GODARC0/hardware-projects/README.md

# Hardware Projects

A collection of my hardware projects — microcontroller builds, embedded systems, circuits, and anything else that isn't purely software.

Not limited to any one platform (Arduino, ESP32, etc.) — this repo just holds all of it.

---

## Structure

Each project lives in its own folder, named after the project. Inside you'll typically find the source code, and any relevant schematics/notes for that build.

```
hardware-projects/
├── Self balancer robot/
├── evm/
├── password based lock/
└── ...more added over time
```

New projects get added as new top-level folders.

---

## License

MIT
