GODARC0/hardware-projects/Self balancer robot/images and diagram/Block_diagram.png

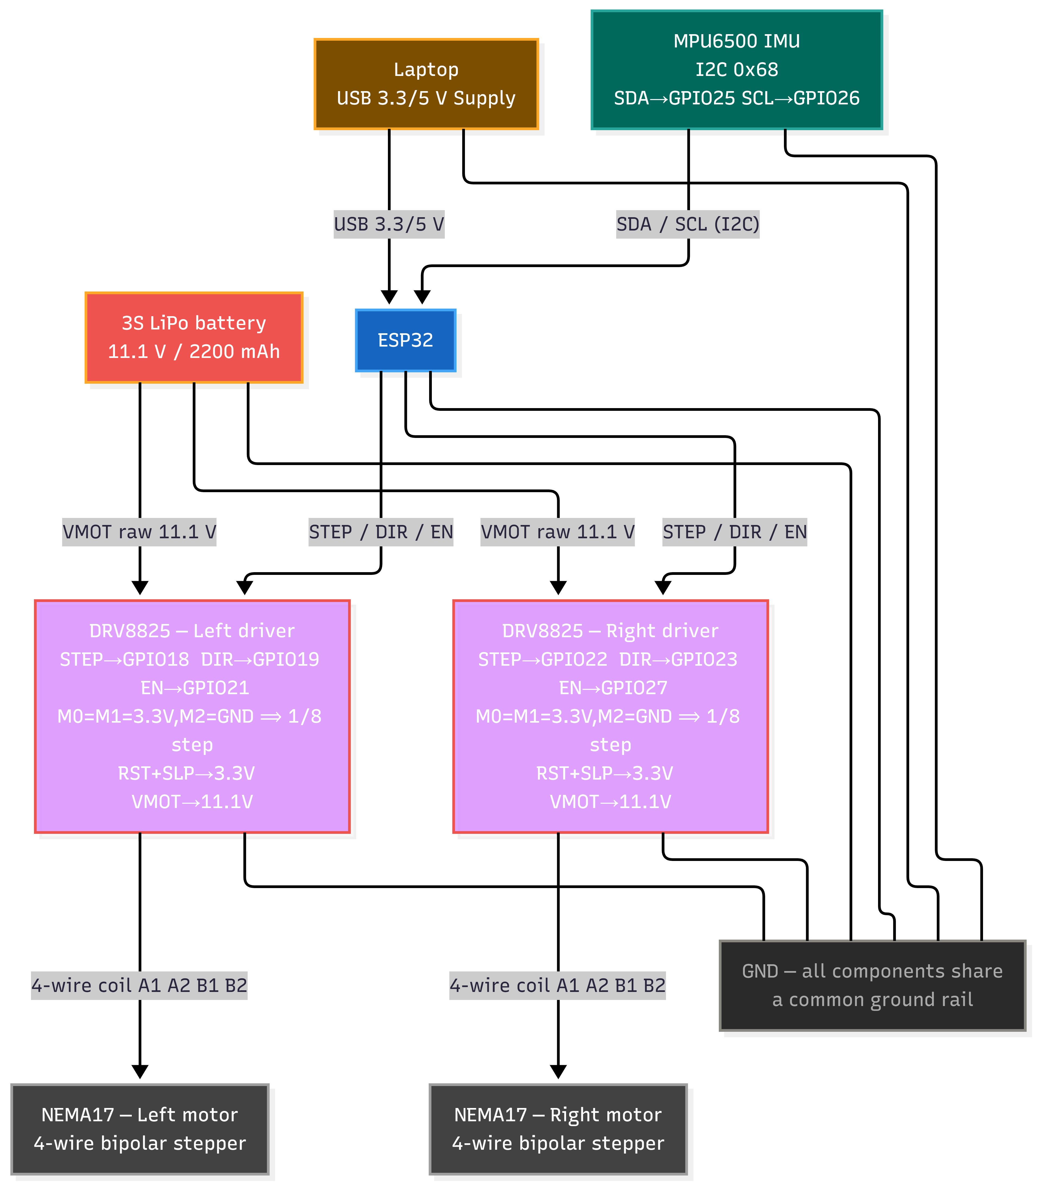
Self balancer robot/images and diagram/Block_diagram.png
