GODARC0/hardware-projects/Self balancer robot/images and diagram/Circuit_diagram.png

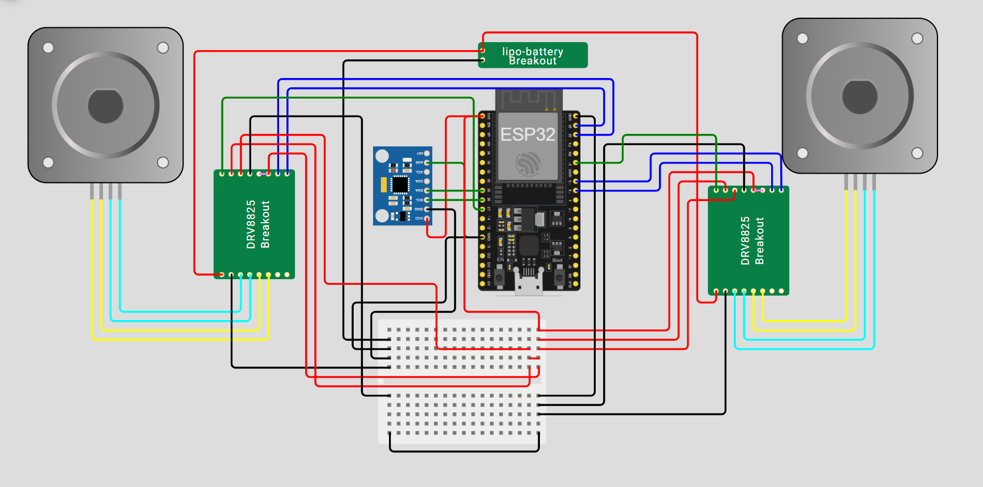
Self balancer robot/images and diagram/Circuit_diagram.png
