GODARC0/hardware-projects/Self balancer robot/images and diagram/data.png

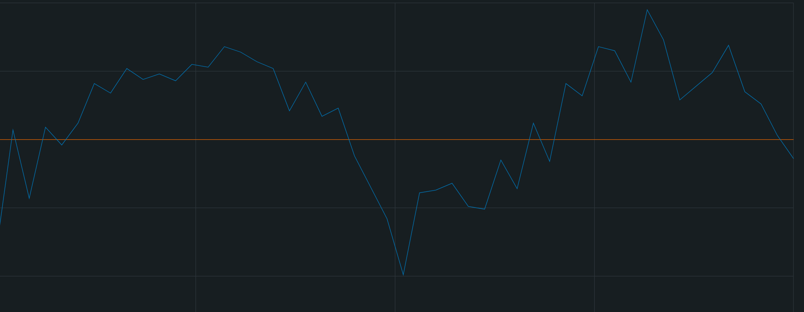
Self balancer robot/images and diagram/data.png
