GODARC0/hardware-projects/Self balancer robot/images and diagram/ESP-32 (1).png

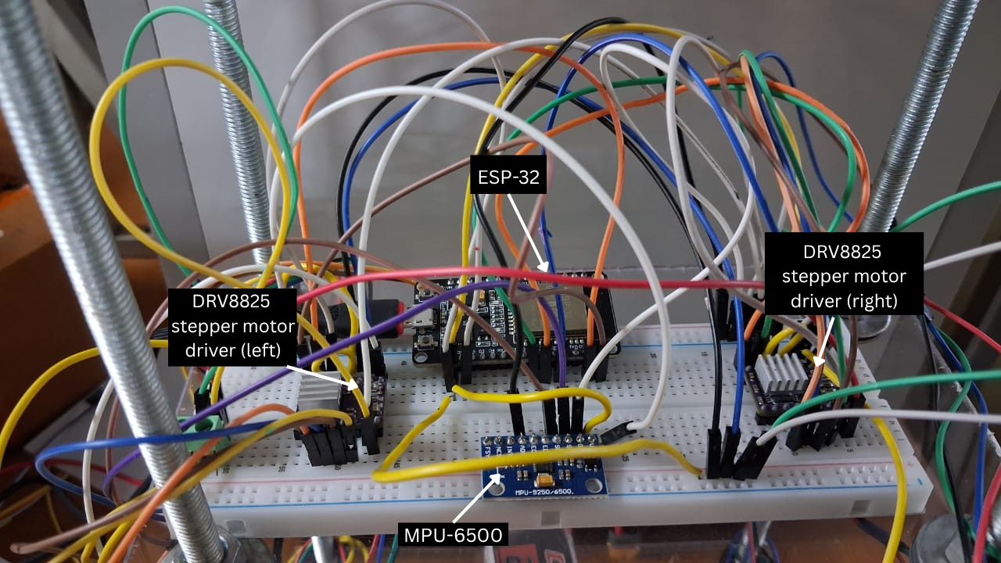
Self balancer robot/images and diagram/ESP-32 (1).png
