GODARC0/hardware-projects/Self balancer robot/images and diagram/Lipo Battery.png

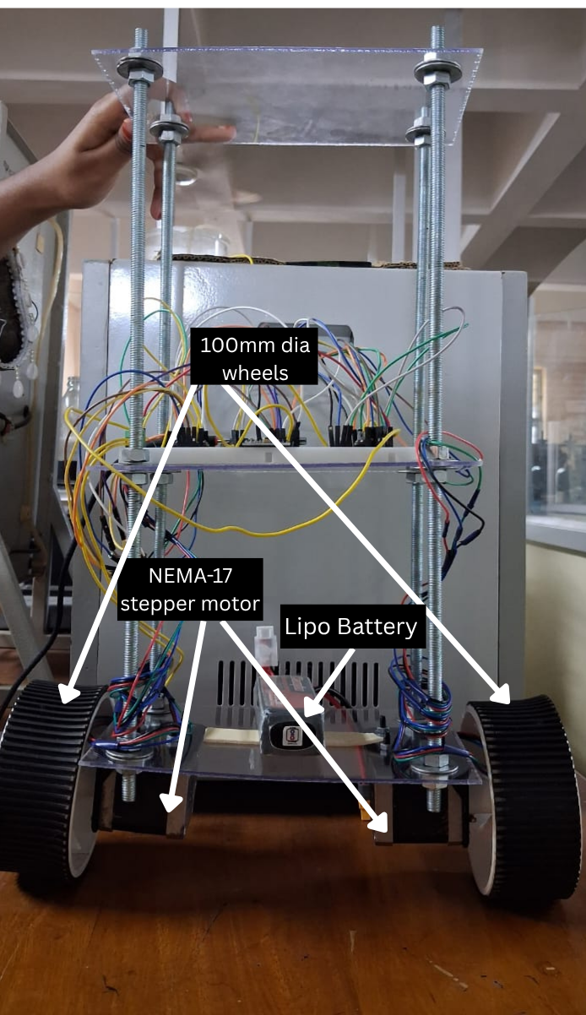
Self balancer robot/images and diagram/Lipo Battery.png
