GODARC0/hardware-projects/Self balancer robot/images and diagram/SBR_PID.png

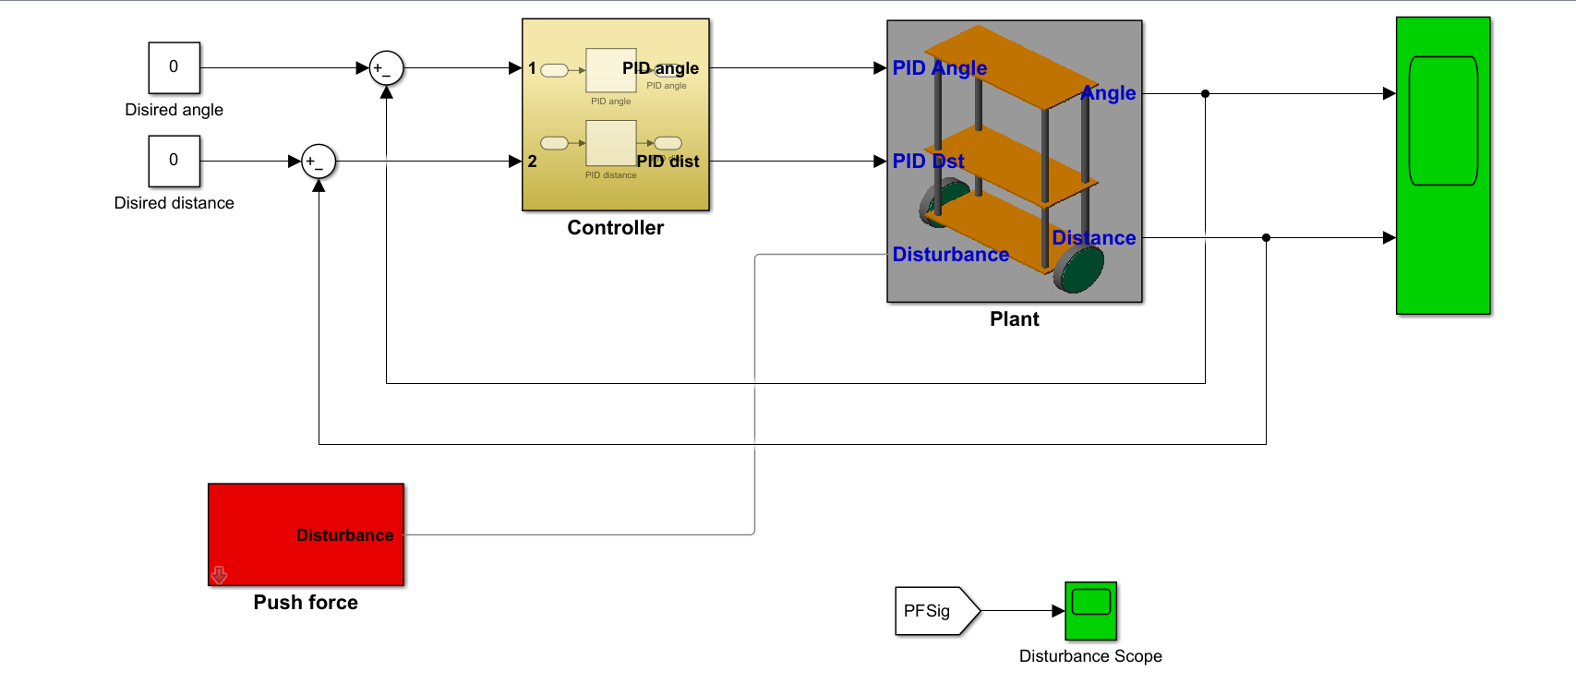
Self balancer robot/images and diagram/SBR_PID.png
