GODARC0/hardware-projects/(commit log)

2026-06-16 finishing the PID based control
2026-07-14 used to check MPU6500
    This code was used to check if the IMU is working or not and getting the output on the serial monitor .
2026-07-14 check working of motor and drivers
    this code is used to check the working of the stepper motor(NEMA17) and motor driver (drv8825)
2026-07-14 Verify gyro and accel agree on pitch direction
2026-07-14 to Verify motor direction polarity
2026-07-14 PID firmware code
2026-07-14 earliar version of PID code
2026-07-14 Renders a 2D animation frame of the cart-pendulum system (cart, wheels, pendulum arm, and bob) for a given state vector.
2026-07-14 Designs a Kalman filter estimator for the linearized cart-pendulum system
2026-07-14 Derives the linearized state-space model of the Two Wheel SBR using measured robot parameters (mass, length, damping), then designs continuous and discrete full-state and reduced 3-state LQR gains (d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
2026-07-14 Checks observability of the linearized cart-pendulum system for different candidate sensor sets (full 4-state and reduced 3-state), evaluating which state measurements are sufficient to reconstruct t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
2026-07-14 simulation of PID
